RichDeFano/IoT-Thermometer/README.md

# IoT-Thermometer
An IoT thermometer. Data is available in real time on a web page, as well as the embedded system.
